Aquesnail/3PhaseInverter/Hardware/G474VC_Core/G474VC_Core.pdf

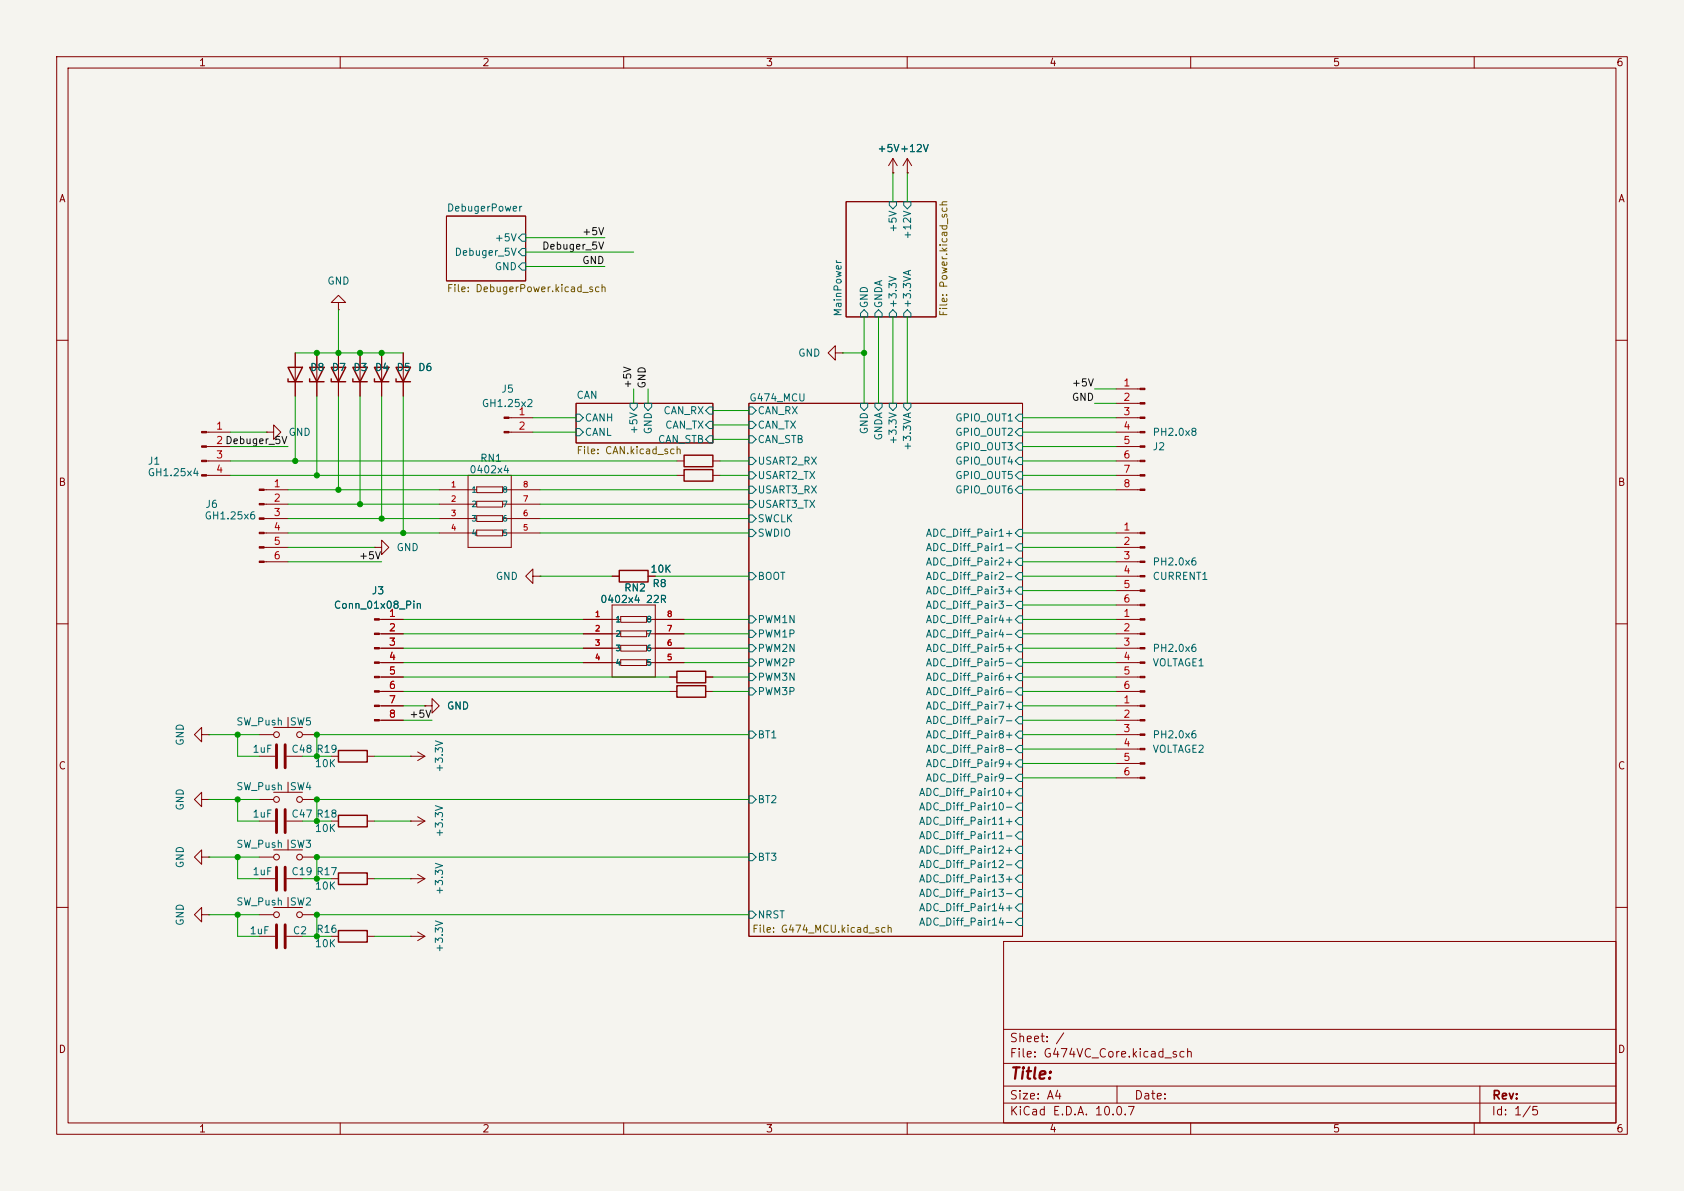
[picture p1: page 1]

Size: A4 | Rev:
KiCad E.D.A. 10.0.7 | Id: 1/5

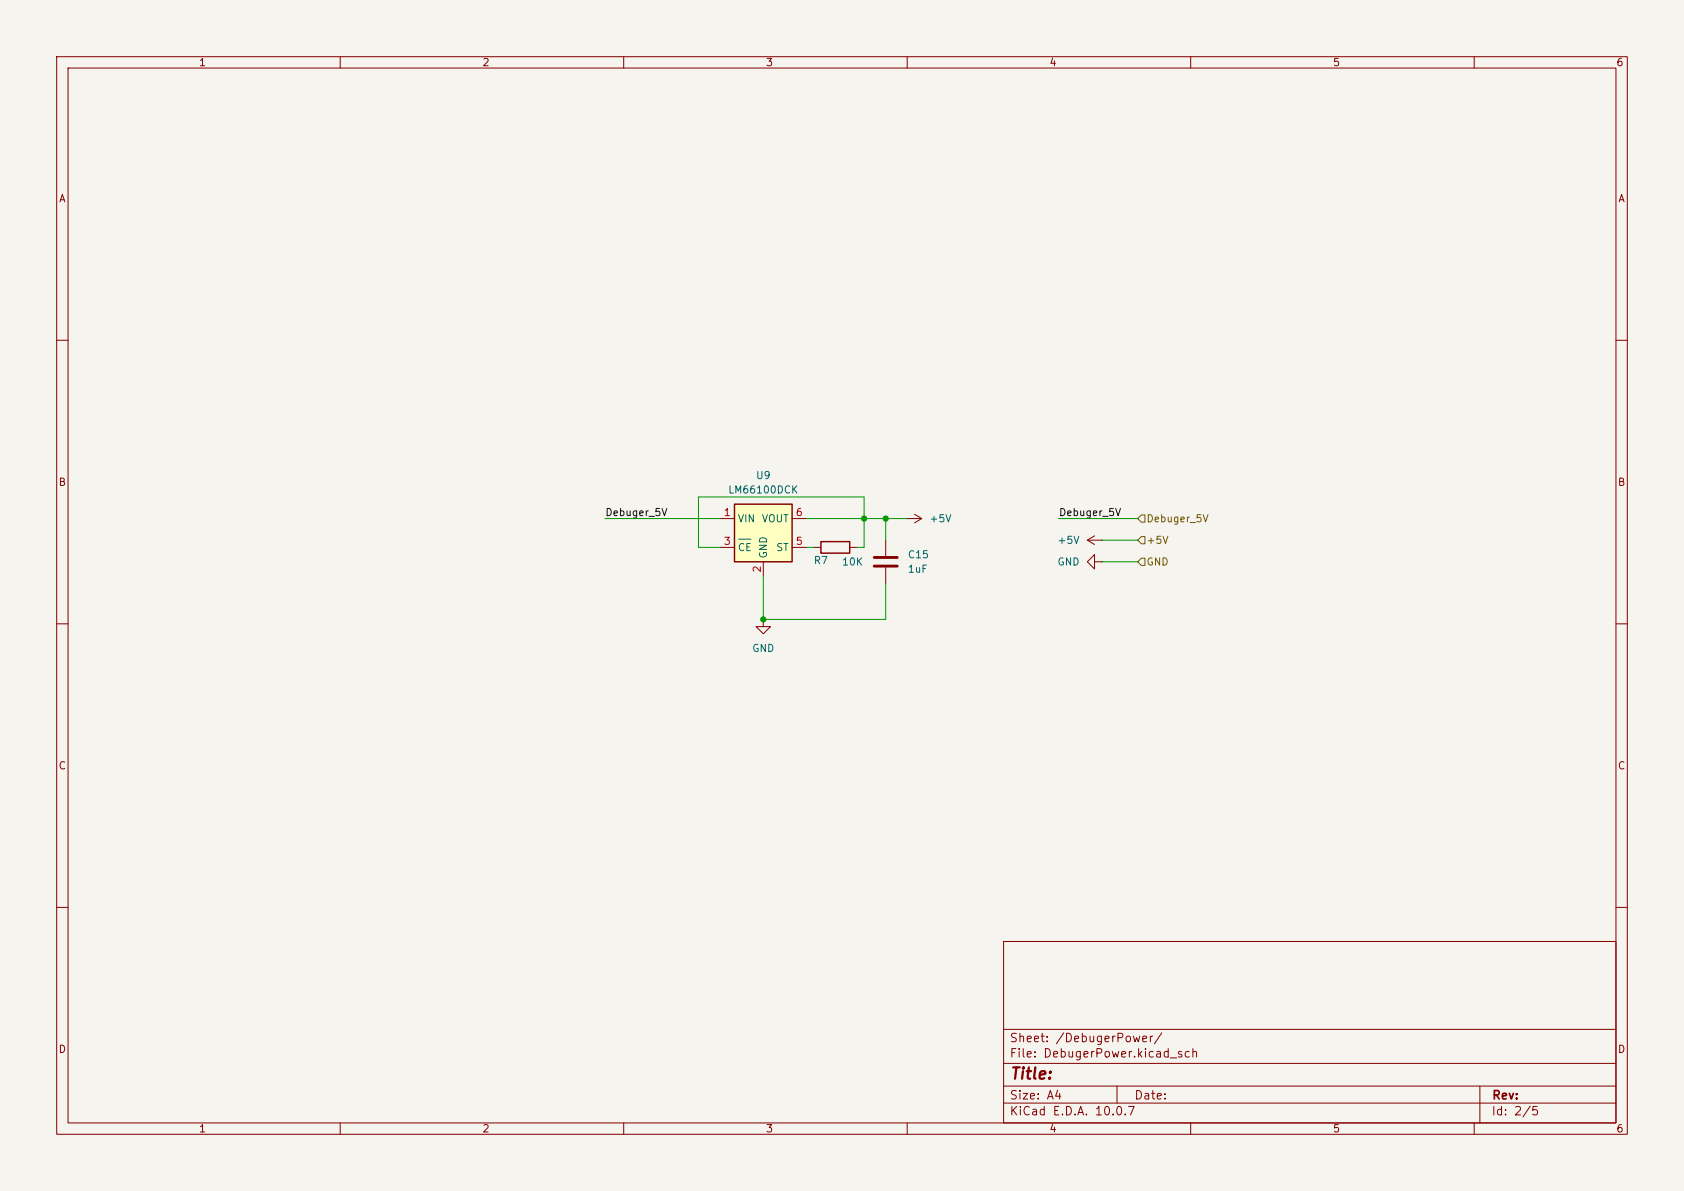
[picture p2: page 2]

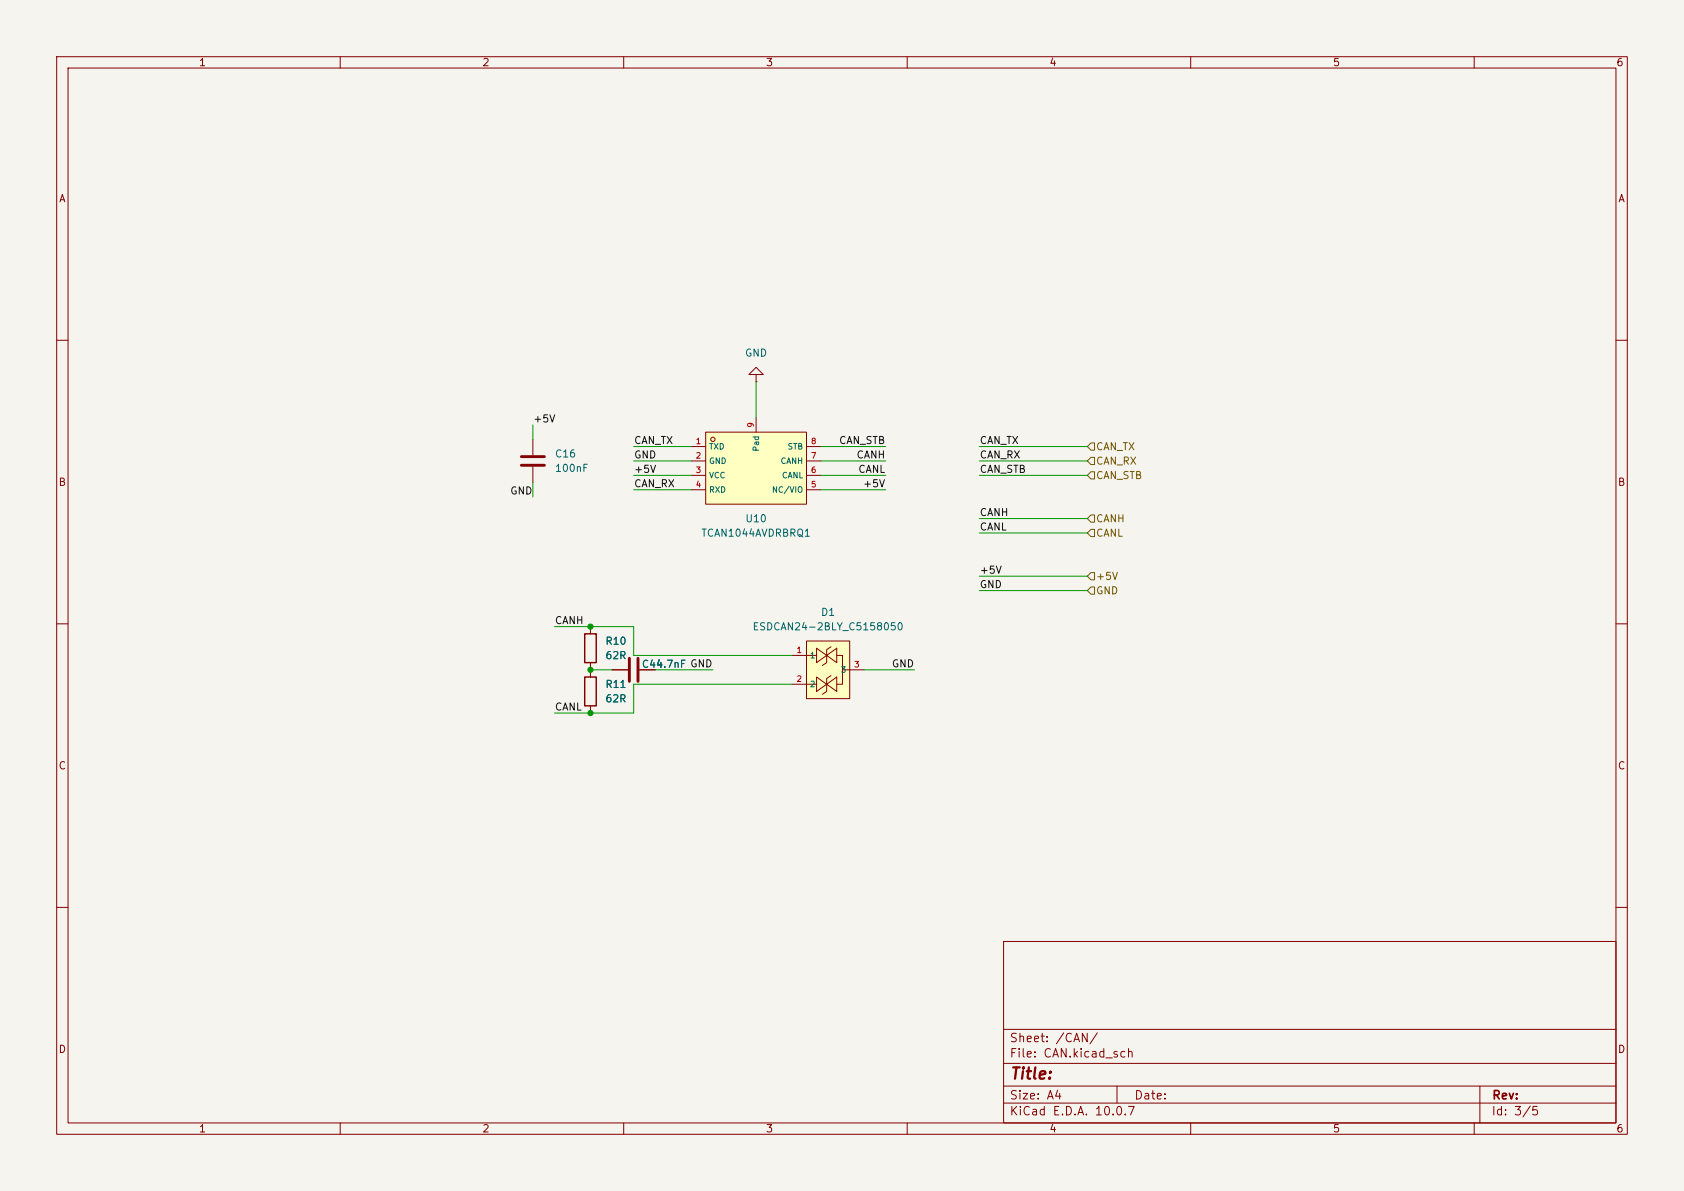
[picture p3: page 3]

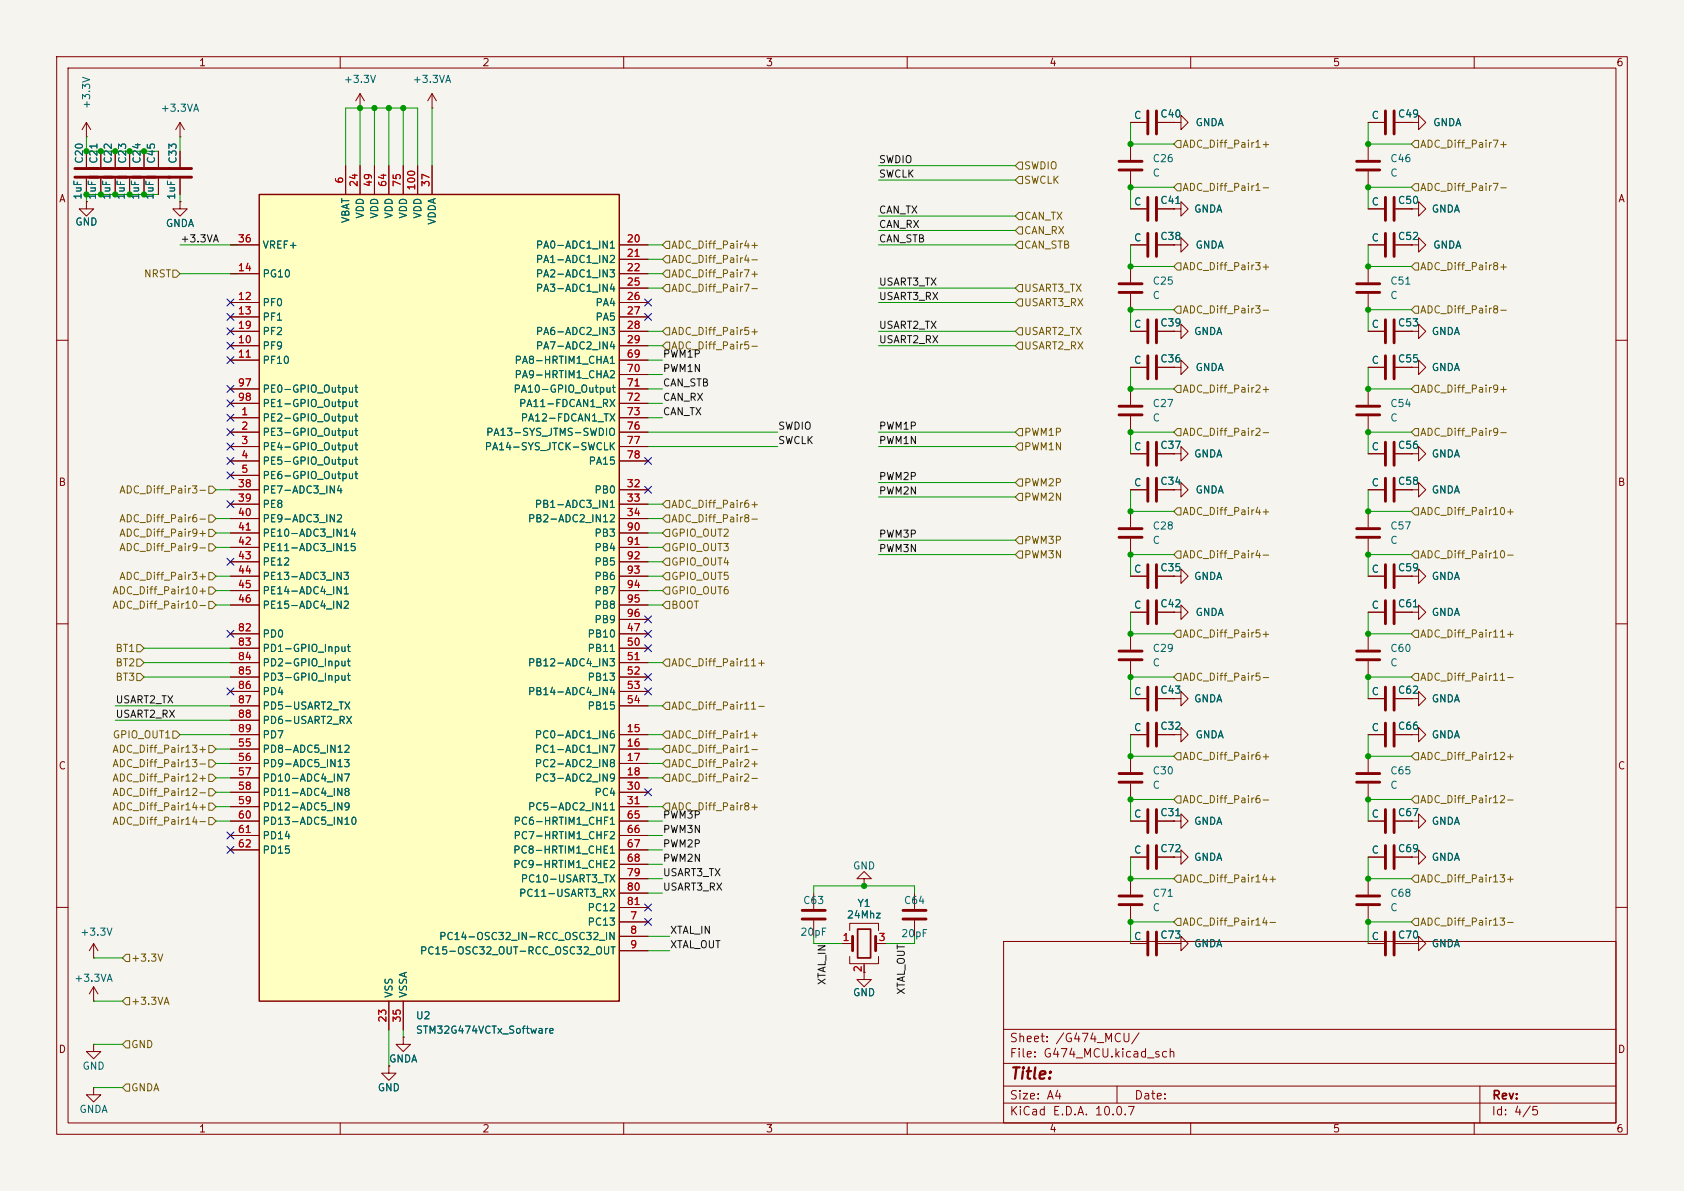
[picture p4: page 4]

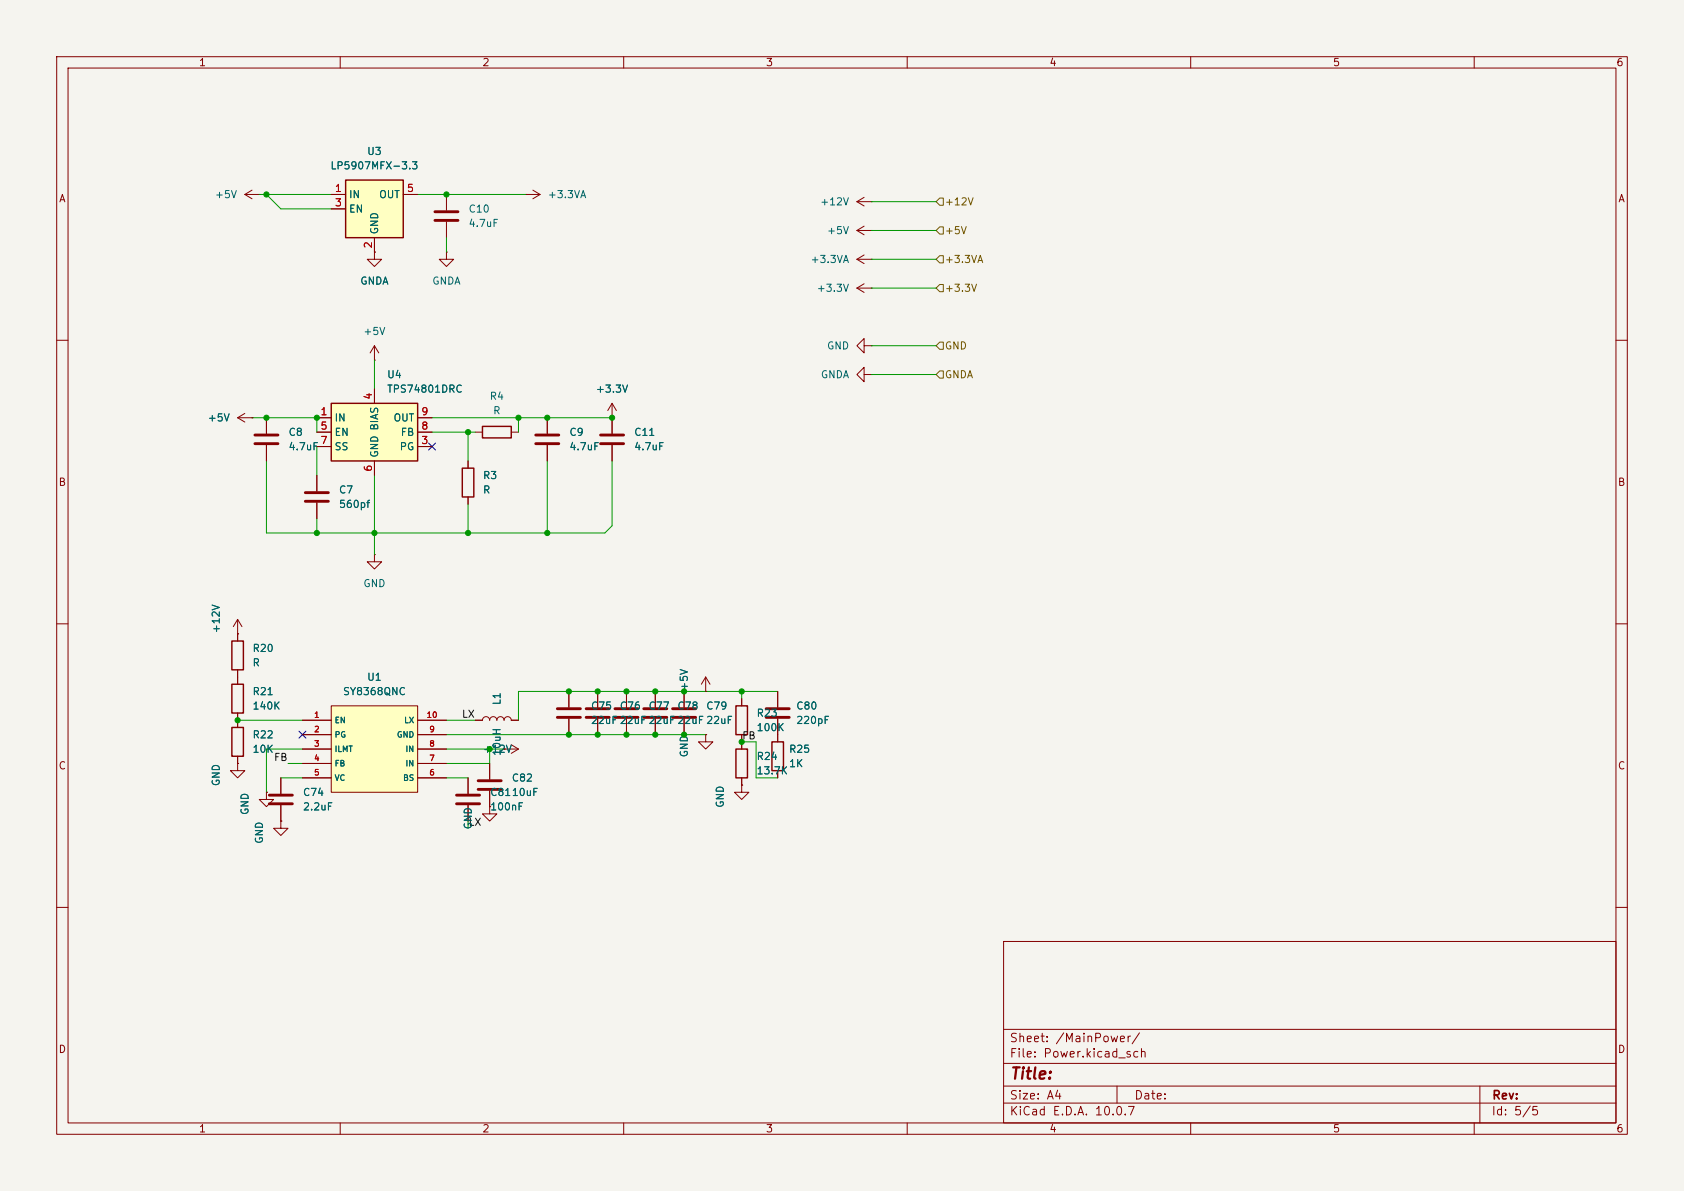
[picture p5: page 5]
