Aquesnail/3PhaseInverter/Software/G474_Software.ioc

Mcu.UserName=STM32G474VCTx
PA0.Signal=ADC1_IN1
PA1.Signal=ADC1_IN2
PA10.Signal=GPIO_Output
PA11.Signal=FDCAN1_RX
PA12.Signal=FDCAN1_TX
PA13.Signal=SYS_JTMS-SWDIO
PA14.Signal=SYS_JTCK-SWCLK
PA2.Signal=ADC1_IN3
PA3.Signal=ADC1_IN4
PA6.Signal=ADC2_IN3
PA7.Signal=ADC2_IN4
PA8.Signal=HRTIM1_CHA1
PA9.Signal=HRTIM1_CHA2
PB1.Signal=ADC3_IN1
PB12.Signal=ADC4_IN3
PB14.Signal=ADC4_IN4
PB2.Signal=ADC2_IN12
PC0.Signal=ADC1_IN6
PC1.Signal=ADC1_IN7
PC10.Signal=USART3_TX
PC11.Signal=USART3_RX
PC14-OSC32_IN.Signal=RCC_OSC32_IN
PC15-OSC32_OUT.Signal=RCC_OSC32_OUT
PC2.Signal=ADC2_IN8
PC3.Signal=ADC2_IN9
PC5.Signal=ADC2_IN11
PC6.Signal=HRTIM1_CHF1
PC7.Signal=HRTIM1_CHF2
PC8.Signal=HRTIM1_CHE1
PC9.Signal=HRTIM1_CHE2
PD1.Signal=GPIO_Input
PD10.Signal=ADC4_IN7
PD11.Signal=ADC4_IN8
PD12.Signal=ADC5_IN9
PD13.Signal=ADC5_IN10
PD2.Signal=GPIO_Input
PD3.Signal=GPIO_Input
PD5.Signal=USART2_TX
PD6.Signal=USART2_RX
PD8.Signal=ADC5_IN12
PD9.Signal=ADC5_IN13
PE0.Signal=GPIO_Output
PE1.Signal=GPIO_Output
PE10.Signal=ADC3_IN14
PE11.Signal=ADC3_IN15
PE13.Signal=ADC3_IN3
PE14.Signal=ADC4_IN1
PE15.Signal=ADC4_IN2
PE2.Signal=GPIO_Output
PE3.Signal=GPIO_Output
PE4.Signal=GPIO_Output
PE5.Signal=GPIO_Output
PE7.Signal=ADC3_IN4
PE9.Signal=ADC3_IN2
