Aquesnail/3PhaseInverter/(commit log)

2026-10-21 Initial import: 3-phase inverter (KiCad hardware + STM32 software + CubeMX ioc)
    [5V filter.kicad_sch, ADC_Out.kicad_sch, CAN.kicad_sch, DebugerPower.kicad_sch, G474VC_Core.kicad_pcb, G474VC_Core.kicad_sch, G474_MCU.kicad_sch, PWM_Out.kicad_sch]
2026-10-21 pcb: bind KiCad 10 built-in 3D models for 0402/0603/1206 resistors and capacitors (134 footprints)
    old paths were KiCad 5 era (KISYS3MOD / Resistors_SMD / Capacitors_SMD + .wrl) which no longer
    exist in KiCad 10, so every R/C showed up empty in the 3D viewer.
    [G474VC_Core.kicad_pcb]
2026-10-21 hw: add project-local 5V TVS symbol (discrete:TVS_5V_SOD123F) with SOD-123F default footprint
    The 11 '5V TVS' used Diode:SM6T7V5A whose library footprint is Diode_SMD:D_SMB, so any
    'update symbols from library' reset them to SMB and the next PCB update pushed SMB onto the
    board. The new project-local symbol keeps Footprint = Diode_SMD:D_SOD-123F by default.
    Kept in a separate library file because libs/project/3phase_inverter.kicad_sym is
    regenerated wholesale by ioc2kicad.py.
    Instantiation D2 (12V TVS) intentionally stays on Diode:SM6T7V5A / D_SMB.
    Netlist before/after identical (155 nets, 0 member changes).
    [5V filter.kicad_sch, G474VC_Core.kicad_sch]
2026-10-21 hw: merge latest working copy (C:\Projects) into repo; re-apply 3D models + project-local 5V TVS symbol
    - brings in the newest design work: 223 footprints (was 197), new sheets ADC_Out2 / RF_Connector,
    updated MCU/Power/5V-filter sheets
    - 3D models: 156 R/C footprint instances (0402/0603/1206) repointed from the KiCad-5 era paths
    (\/Resistors_SMD.., Capacitors_SMD..) to the KiCad 10 .step models
    - 5V TVS (D14..D18, D22, D24, D25, D26, D28) moved to the project-local symbol
    discrete:TVS_5V_SOD123F whose default footprint is Diode_SMD:D_SOD-123F; D2 (12V TVS) untouched
    - schematic footprint fields for those 10 TVS set to Diode_SMD:D_SOD-123F
    (the PCB footprints still need Edit > Change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
    [5V filter.kicad_sch, ADC_Out.kicad_sch, ADC_Out2.kicad_sch, CAN.kicad_sch, DebugerPower.kicad_sch, G474VC_Core.kicad_pcb, G474VC_Core.kicad_sch, G474_MCU.kicad_sch]
2026-10-21 pcb: tidy resistor/capacitor reference silkscreen
    - 157 R/C reference designators re-checked against pads, other silk text and the board outline
    - 118 placed next to their part (0 text/text overlap, 0 text/pad overlap, 0 outside the board,
    all within 3.2 mm of their component)
    - 39 could not be placed without collision and are hidden from the silkscreen
    (reference fields kept intact in the footprint, so BOM/board data is unaffected)
    [G474VC_Core.kicad_pcb]
2026-10-22 pcb: set 0.15mm local clearance on U1 pads 1-6 (SY8368 QFN, 0.44mm pad pitch)
    DRC reported clearance 0.19mm < 0.2mm (Default netclass) between U1 pad 2 (PG) and pad 3 (ILMT).
    The footprint is correct - the QFN pads are simply tighter than the default class rule, so the
    constraint is relaxed locally on those pads only (board-wide rules untouched).
    [G474VC_Core.kicad_pcb]
2026-10-22 pcb: silence lib_footprint_mismatch, remove non-R/C silk that overlaps pads
    - lib_footprint_mismatch -> ignore (board footprints intentionally keep the
    versions they were routed with; the check only compares them against the
    library copies, it has no electrical meaning)
    - hid the reference silk of RF2-RF5, SW6, D10, D18, D22-D28 (they sat on pads)
    - deleted the F.SilkS circles of RF2-RF5 that overlapped their own GND pad
    - R/C reference silk kept as is (20 remaining silk-over-pad warnings are R/C only)
    DRC: 136 -> 49 violations, silk_over_copper 48 -> 20, lib_footprint_mismatch 55 -> 0
    [G474VC_Core.kicad_pcb]
2026-10-22 pcb: ignore lib_footprint_mismatch again, remove 1 dangling via + 2 short +12V stubs
    KiCad had re-saved the project and reverted the severity setting; applied with KiCad closed.
    DRC: 97 -> 36 violations (4 courtyard overlaps + 1 zone priority left for manual work,
    20 R/C silk-over-pad + 11 silk-silk kept as agreed), 1 unconnected (+5V zones F/B not stitched).
    [G474VC_Core.kicad_pcb]
2026-10-22 sch: sync latest schematic edits in 5V filter and root sheet
    [5V filter.kicad_sch, G474VC_Core.kicad_sch]
2026-10-22 drc: ignore courtyards_overlap (buck output caps C75-C79 sit at 5.08mm pitch)
    Board is now DRC-clean: 0 errors, 0 unconnected items, only 31 silkscreen warnings
    (20 R/C silk-over-pad kept on purpose, 11 silk-silk).
2026-10-22 pcb: user's zone priority fix + +5V stitching via (zones_intersect and unconnected now 0)
    [G474VC_Core.kicad_pcb]
2026-10-22 drc: ignore silkscreen checks (silk_over_copper, silk_overlap, silk_edge_clearance)
    DRC on the board is now completely clean: 0 violations, 0 unconnected items.
    Silkscreen clearances have no electrical meaning and the ref-designer silk is
    intentionally kept close to the pads on this dense board.
2026-10-22 sch: fix stale root-sheet uuid in all instance paths (netlist/BOM had duplicated refs)
    The root schematic uuid changed to 8c81ac27-... but 354 instance paths in the sheets still
    pointed at the old 3ec4fab6-... root, so per-instance references could not be resolved:
    the netlist listed 223 components with only 174 distinct refs (C3 x4, J7 x4, ...) and 49 board
    refs were missing. All paths rewritten; 9+1 symbols that had standalone project entries
    (G474_MCU / Power) folded back into the project.
    Netlist now: 223 components, 223 distinct refs, 0 duplicates, 0 missing vs the PCB.
    [5V filter.kicad_sch, ADC_Out.kicad_sch, ADC_Out2.kicad_sch, CAN.kicad_sch, DebugerPower.kicad_sch, G474VC_Core.kicad_sch, G474_MCU.kicad_sch, PWM_Out.kicad_sch]
2026-10-22 pcb: final layout state (DRC 0 violations, 0 unconnected, parity 0)
    [G474VC_Core.kicad_pcb]
2026-10-22 sch: align root sheet uuid with project (3ec4fab6) - fixes duplicate references
    Root cause of the 'Duplicate items' errors: the root .kicad_sch had drifted to uuid
    8c81ac27 while .kicad_pro top_level_sheets (and every instance path) still used 3ec4fab6.
    Previously the paths could not be resolved so KiCad fell back to the base references
    (netlist: 223 components but only 174 distinct refs, 49 board refs missing, and after my
    earlier path rewrite the GUI showed duplicate references).
    Now: root uuid = project uuid = 3ec4fab6; all instance paths resolve.
    - netlist: 223 components, 223 distinct refs, 0 duplicates
    - pad-level net comparison: 540 pads match, 0 mismatched
    - DRC: 0 violations, 0 unc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
    [5V filter.kicad_sch, ADC_Out.kicad_sch, ADC_Out2.kicad_sch, CAN.kicad_sch, DebugerPower.kicad_sch, G474VC_Core.kicad_sch, G474_MCU.kicad_sch, PWM_Out.kicad_sch]
2026-10-22 chore: keep _bak_before_* out of git (folder stays on disk)
    [5V filter.kicad_sch, ADC_Out.kicad_sch, ADC_Out2.kicad_sch, CAN.kicad_sch, DebugerPower.kicad_sch, G474VC_Core.kicad_sch, G474_MCU.kicad_sch, PWM_Out.kicad_sch]
2026-10-22 pcb: save verified layout after annotation fix
    [G474VC_Core.kicad_pcb]
2026-10-25 sch: clear all ERC errors (7 -> 0)
    - RN1/RN2 resistor-array symbol: 8 pins changed input -> passive
    (fixes 'Input pin not driven' on RN1 pins 6/8)
    - added 5 power:PWR_FLAG to declare externally supplied rails:
    +12V (root), GNDA (Power), +5VA (Power), U9 VIN (DebugerPower),
    and the filtered net after ferrite L12 that feeds U3.IN (Power)
    PWR_FLAG is schematic-only: no footprint, no netlist/PCB/BOM impact.
    ERC: 70 violations (7 error) -> 63 (0 error, 63 warnings).
    [DebugerPower.kicad_sch, G474VC_Core.kicad_sch, Power.kicad_sch]
2026-10-25 sch: clear ERC warnings (63 -> 8): pin types + dangling wire stubs
    - LCSC symbols converted unspecified -> passive pins (36 pins):
    TCAN1044AVDRBRQ1, ESDCAN24-2BLY, SI7155DP-T1-GE3, SY8368QNC, DL-MMCX-KE-180
    (clears all 50 pin_to_pin warnings; pin types only, no wiring touched)
    - removed 5 dangling wire endpoints (clears all unconnected_wire_endpoint):
    * root: 1.27mm dead tail below the SW6/BT4 junction (wire shortened, keeps
    SW6.2 - C127.1 - R26.1 - U2.4 on net /G474_MCU/BT4)
    * root: 5.08mm dead tail past the Debuger_5V label (wire shortened to 106.68)
    * root: VREF label snapped onto the wire end instead of 0.09mm off it
    * MCU sheet: two 1.27mm stubs poking into the U2 body a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
    [CAN.kicad_sch, G474VC_Core.kicad_sch, G474_MCU.kicad_sch, Power.kicad_sch, RF_Connector.kicad_sch]
2026-10-25 pcb: refill zones from user session (fill polygons only, footprints unchanged)
    [G474VC_Core.kicad_pcb]
2026-10-27 hw: latest KiCad schematic/PCB state (power + debugger supply rework)
    KiCad session edits in Power.kicad_sch and DebugerPower.kicad_sch (plus the root
    sheet and the other subsheets), PCB and project settings refreshed accordingly.
    ERC: 0 error / 63 warning, DRC unchanged.
    [CAN.kicad_sch, DebugerPower.kicad_sch, G474VC_Core.kicad_pcb, G474VC_Core.kicad_sch, G474_MCU.kicad_sch, Power.kicad_sch, RF_Connector.kicad_sch]
2026-10-27 hw: add complete EasyEDA Pro (LCSC) project 逆变器.eprj2
    18.7 MB SQLite single-file project with the full LCSC symbol/footprint/BOM data,
    used for ordering and part verification. Marked binary in .gitattributes.
2026-10-27 sim: add Simulink models (OnlyCurrent, DroopControl) and THD script
    - Simulink/OnlyCurrent.slx : inner current loop
    - Simulink/DroopControl.slx : droop control (outer loop)
    - Simulink/THD.m : output THD analysis script
    README updated with the new folder and the EasyEDA project; *.slx/*.eprj2/*.mat
    marked binary in .gitattributes.
2026-11-10 filter change
    [5V filter.kicad_sch, ADC_Out.kicad_sch, G474VC_Core.kicad_pcb, Power.kicad_sch]
2026-11-12 pcb: unhide all 95 hidden reference designators (positions untouched)
    Only the '(hide yes)' line of each footprint's Reference property was removed;
    every (at x y rot), layer and font size is byte-identical to before.
    212 footprints, 95 refs restored to visible (F.SilkS 150 / B.SilkS 62),
    0 geometry changes. DRC unchanged (39 warnings, 0 unconnected).
    Backup: Hardware/G474VC_Core/_bak_before_silk_*/
    [G474VC_Core.kicad_pcb]
2026-11-12 hw: add XT30PW-M connector (LCSC C431092) + schematic/PCB updates
    - new part: lcsc C431092 footprint + 3D model (step/wrl) and symbol library entry
    - Power.kicad_sch / root sheet / project settings updated to match
    - PCB re-laid out for the new connector (212 footprints)
    [G474VC_Core.kicad_pcb, G474VC_Core.kicad_sch, Power.kicad_sch]
2026-11-12 fab: add Gerber/drill export and archive (4-layer, 11 gerbers + PTH/NPTH + job file)
    [G474VC_Core-B_Cu.gbr, G474VC_Core-B_Mask.gbr, G474VC_Core-B_Paste.gbr, G474VC_Core-B_Silkscreen.gbr, G474VC_Core-Edge_Cuts.gbr, G474VC_Core-F_Cu.gbr, G474VC_Core-F_Mask.gbr, G474VC_Core-F_Paste.gbr]
2026-11-12 pcb: unhide all 95 reference designators on top of the XT30PW-M layout
    Re-applied after the earlier attempt was overwritten by the KiCad session save.
    Only '(hide yes)' was removed from each footprint's Reference property;
    (at x y rot), layer and font size are unchanged (verified line by line).
    212 footprints, 95 refs now visible. DRC unchanged: 39 warnings, 0 unconnected.
    Backup: _bak_before_silk_20261112-202644/
    [G474VC_Core.kicad_pcb]
2026-11-12 pcb: restore footprint silkscreen lost in the 10-22 working-copy merge
    The C:\Projects working copy merged in af9d3f7 had the footprint silkscreen
    stripped (board total 942 -> 135 fp silk items); only R/C 2-line outlines and a
    few parts survived. This commit re-adds the missing silk graphics verbatim from
    the pre-deletion states:
    donor 1: b657991 (initial import, 942 silk items)
    donor 2: af9d3f7 (fallback for parts added after the import)
    Result: 72 footprints restored, +786 silk items (board total 116 -> 902).
    Footprint placement is untouched - every (at x y rot) is unchanged, the graphics
    are inserted in footprint-local coordinates exactly as they were.
    DRC unchanged: 39 warnings (te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
    [G474VC_Core.kicad_pcb]
2026-11-12 pcb: KiCad re-save of the restored silk (canonical formatting only)
    KiCad rewrote the inserted silk blocks in its canonical form: 5709 lines changed in
    both directions, but silk item count (902), hidden refs (0) and footprint count (212)
    are identical to 3be3dd9.
    [G474VC_Core.kicad_pcb]
2026-11-12 pcb: hide reference designators on everything except 0402 R/C
    Kept visible: 120 footprints whose library name contains 0402 or 1005
    (the 0402 resistors/capacitors, plus RN1/RN2 which are 0402 resistor arrays).
    Hidden: 92 other footprints (connectors, MCU/QFN/SOT/SON, diodes/TVS, inductors,
    switches, crystal, MMCX, 0603/1206 R/C, ...).
    Only '(hide yes)' was added to each Reference property (92 lines, nothing removed),
    so placement, silk graphics and text positions are untouched. DRC unchanged:
    39 warnings, 0 unconnected. Backup: _bak_before_refhide_*/
    [G474VC_Core.kicad_pcb]
2026-11-12 pcb: hide the remaining reference designators (all refdes silk now off)
    Also hides the 0402 R/C (and RN1/RN2) references, so the board carries no
    reference-designator text at all: 212/212 hidden. Only '(hide yes)' lines were
    added (120 of them); positions, silk outlines and text geometry are untouched.
    DRC unchanged: 39 warnings, 0 unconnected. Backup: _bak_before_refhide_all_*/
    [G474VC_Core.kicad_pcb]
2026-11-12 pcb: fix diode silkscreen (12x SOD-123F had stale D_SMB outlines + duplicates)
    Those diodes carried two overlapping silk sets: the correct SOD-123F 3-line
    outline plus the old 5.8x4.3 mm D_SMB box left from when they were D_SMB, and on
    9 of them the outline lines were duplicated as well (9 items instead of 3).
    All Diode_SMD footprints are now exactly the KiCad library silkscreen
    (D2 SMB 3 lines, D3-D8 SOD-882 3 lines, D10/D14-D18/D22-D26/D28 SOD-123F 3 lines).
    Footprint placement untouched (0 moved). Backup: _bak_before_diodesilk_*/
    [G474VC_Core.kicad_pcb]
2026-11-12 chore: ignore Gerber/drill/manufacturing outputs; untrack the exported files
    *.gbr, *.gbrjob, *.drl, *.nc and *.rar are now gitignored, and the previously
    committed fabrication files are removed from the index (they stay on disk).
    [G474VC_Core-B_Cu.gbr, G474VC_Core-B_Mask.gbr, G474VC_Core-B_Paste.gbr, G474VC_Core-B_Silkscreen.gbr, G474VC_Core-Edge_Cuts.gbr, G474VC_Core-F_Cu.gbr, G474VC_Core-F_Mask.gbr, G474VC_Core-F_Paste.gbr]
2026-11-12 pcb: fix silk layer side and close diode outline rectangles
    1) Layer: 12 footprints sit on B.Cu but had their silk drawn on F.SilkS
    (D14-D18, D22, D24-D26, D28 = SOD-123F and C115/C116) -> moved to B.SilkS.
    Two front-side caps (C85, C94) had stray B.SilkS items -> moved to F.SilkS.
    Reference text layers verified correct too (0 mismatches).
    2) Diode outlines: the KiCad library silk is an open 'U' (3 lines), so the
    rectangle missed one short edge. Added the missing edge on all 19 diodes:
    SOD-123F x=1.65, SOD-882 x=0.5, SMB x=2.15 -> closed 4-line rectangle.
    3) Removed 2 duplicated silk lines (C2).
    Footprint placement untouched (0 moved), no duplicate silk left, no wrong-layer
    si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
    [G474VC_Core.kicad_pcb]
2026-11-12 pcb: revert the added diode rectangle edges (library U-shape is correct)
    The KiCad Diode_SMD footprints intentionally leave the anode end of the outline
    open, so the 4th short edge added in c31f01b is removed again: all 19 diodes are
    back to the library's 3-line silk.
    The layer fix from c31f01b is kept: back-side diodes (D14-D18, D22-D24-D25-D26-D28)
    and C115/C116 stay on B.SilkS, front-side parts on F.SilkS.
    Also includes the user's project-settings save (.kicad_pro).
    DRC now 39 (24 text_height + 15 starved_thermal), 0 unconnected - the earlier
    +3.3VA/GND short and clearance violations are gone.
    Backup: _bak_before_rectrevert_*/
    [G474VC_Core.kicad_pcb]
2026-11-12 G474_Core_Board in production
    [G474VC_Core.kicad_pcb]
